Willlum/Model_M_Blu/refs/EaLr-zAWsAAkqea.jpg

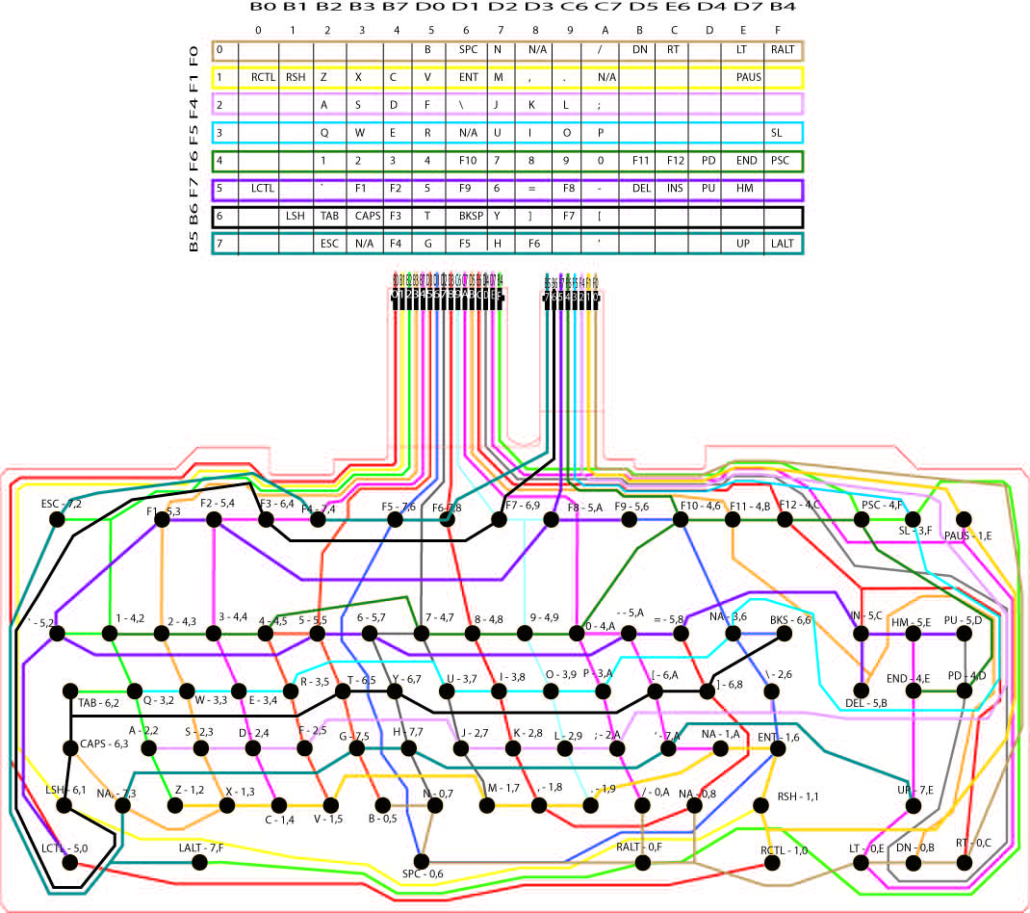
refs/EaLr-zAWsAAkqea.jpg
