Willlum/Model_M_Blu/pcb/BOM.xlsx

Index | Manufacturer Part Number | Manufacturer Name | Description | Attrition % | Datasheet | Note | Original Part numbers
1 | 6-520315-6 | TE Connectivity AMP Connectors | CONN FFC VERT 16POS 2.54MM PCB |  | https://www.te.com/commerce/DocumentDelivery/DDEController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 |  | 6-520315-6-ND
2 | 5-520315-8 | TE Connectivity AMP Connectors | CONN FFC VERT 8POS 2.54MM PCB |  | https://www.te.com/commerce/DocumentDelivery/DDEController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 |  | 5-520315-8-ND
3 | 5-520315-4 | TE Connectivity AMP Connectors | CONN FFC VERT 4POS 2.54MM PCB |  | https://www.te.com/commerce/DocumentDelivery/DDEController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 |  | A123169-ND
4 | PCF8575CDB | Texas Instruments | IC XPNDR 400KHZ I2C SMBUS 24SSOP |  | https://www.ti.com/general/docs/suppproductinfo.tsp?distId=10 |  | 296-33525-5-ND
5 | Huzzah32 |  |  |  | https://www.adafruit.com/product/3405
6 | Lithium Polymer Battery 3.7V |  |  |  | https://www.amazon.com/dp/B095VVR4LB?psc=1&ref=ppx_yo2ov_dt_b_product_details
7 | 1k 0802 RES |  | 1k Ohm
8 | 3k3 0802 RES |  | 3k3 Ohm
