Willlum/Model_M_Blu/pcb/blu_model_m/blu_model_m.kicad_pcb

## KiCad design pcb/blu_model_m/blu_model_m.kicad_pcb (2023-02-08)

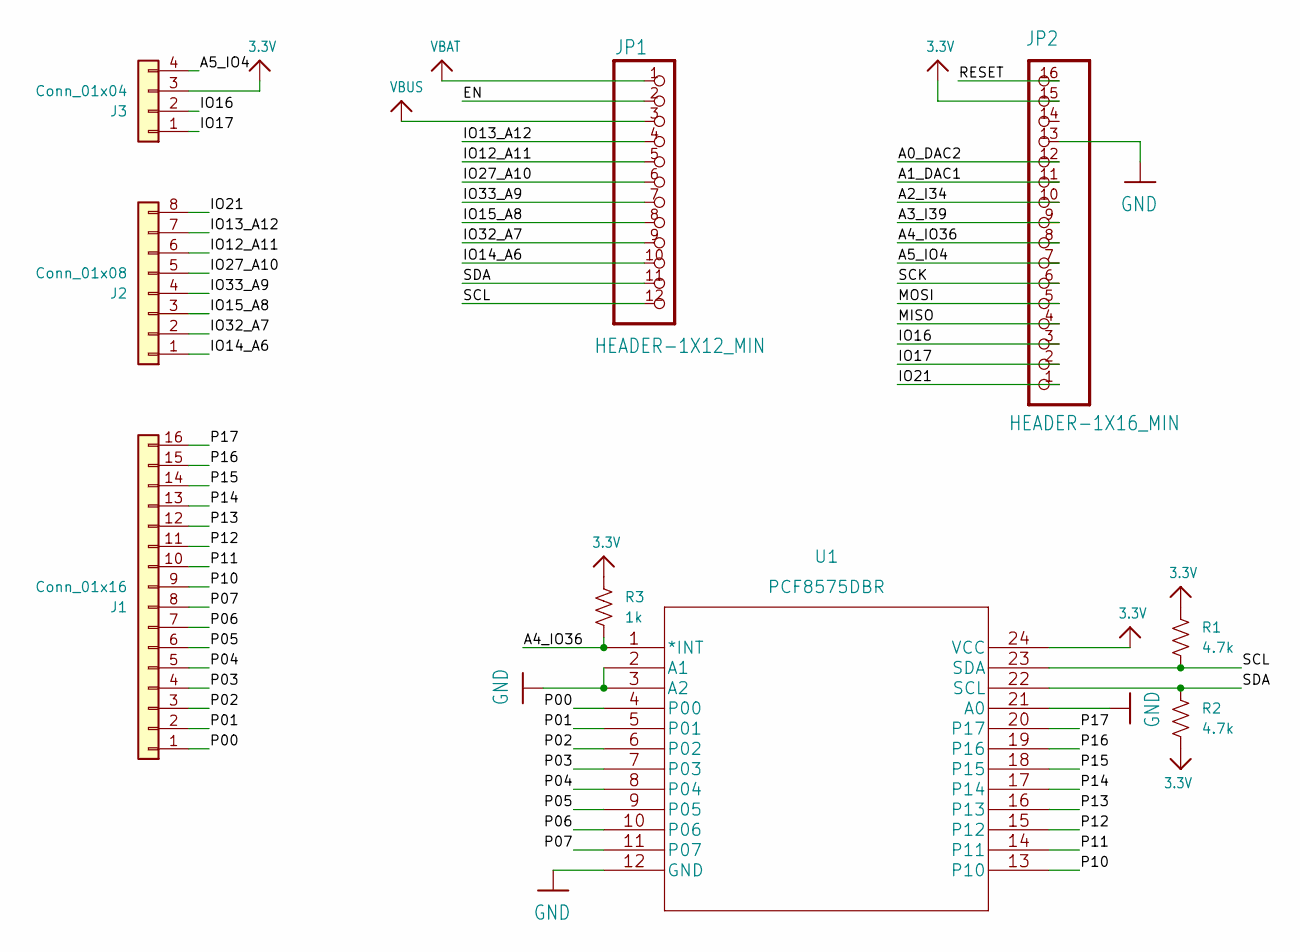
[picture p2: schematic blu_model_m.kicad_sch]

Parts:
J1: Conn_01x16; PinSocket_1x16_P2.54mm_Vertical
J2: Conn_01x08; PinSocket_1x08_P2.54mm_Vertical
J3: Conn_01x04; PinSocket_1x04_P2.54mm_Vertical
JP1: HEADER-1X12_MIN; PinSocket_1x12_P2.54mm_Vertical
JP2: HEADER-1X16_MIN; PinSocket_1x16_P2.54mm_Vertical
R1, R2: 4.7k; R_0805_2012Metric_Pad1.20x1.40mm_HandSolder
R3: 1k; R_0805_2012Metric_Pad1.20x1.40mm_HandSolder
U1: PCF8575DBR; SSOP-24_5.3x8.2mm_P0.65mm

Connections:
3.3V: J3.3, JP2.15, R1.1, R2.2, R3.1, U1.24 (VCC)
/A0_DAC2: JP2.12
/A1_DAC1: JP2.11
/A2_I34: JP2.10
/A3_I39: JP2.9
/A4_IO36: JP2.8, R3.2, U1.1 (*INT)
/A5_IO4: J3.4, JP2.7
/EN: JP1.2
/IO12_A11: J2.6, JP1.5
/IO13_A12: J2.7, JP1.4
/IO14_A6: J2.1, JP1.10
/IO15_A8: J2.3, JP1.8
/IO16: J3.2, JP2.3
/IO17: J3.1, JP2.2
/IO21: J2.8, JP2.1
/IO27_A10: J2.5, JP1.6
/IO32_A7: J2.2, JP1.9
/IO33_A9: J2.4, JP1.7
/MISO: JP2.4
/MOSI: JP2.5
/P00: J1.1, U1.4 (P00)
/P01: J1.2, U1.5 (P01)
/P02: J1.3, U1.6 (P02)
/P03: J1.4, U1.7 (P03)
/P04: J1.5, U1.8 (P04)
/P05: J1.6, U1.9 (P05)
/P06: J1.7, U1.10 (P06)
/P07: J1.8, U1.11 (P07)
/P10: J1.9, U1.13 (P10)
/P11: J1.10, U1.14 (P11)
/P12: J1.11, U1.15 (P12)
/P13: J1.12, U1.16 (P13)
/P14: J1.13, U1.17 (P14)
/P15: J1.14, U1.18 (P15)
/P16: J1.15, U1.19 (P16)
/P17: J1.16, U1.20 (P17)
/RESET: JP2.16
/SCK: JP2.6
/SCL: JP1.12, R1.2, U1.23 (SDA)
/SDA: JP1.11, R2.1, U1.22 (SCL)
GND: JP2.13, U1.2 (A1), U1.3 (A2), U1.12 (GND), U1.21 (A0)
VBAT: JP1.1
VBUS: JP1.3

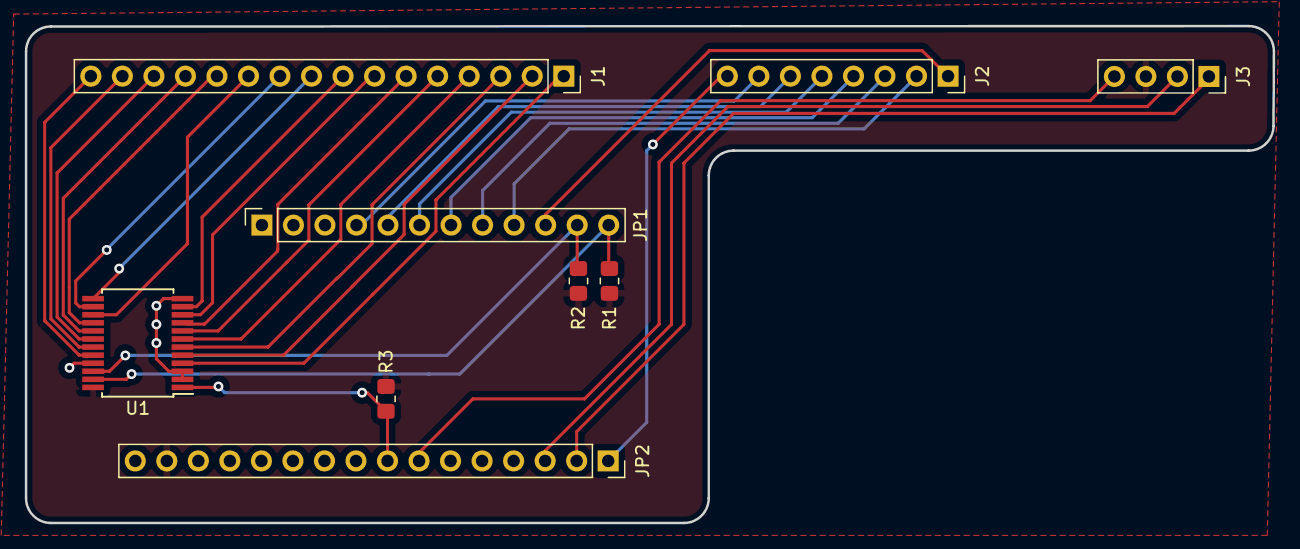
[picture p3: board blu_model_m.kicad_pcb from above]

Board: 2 copper layers, 100.5 x 40.0 mm, 9 parts (0 on the bottom side), 32 nets.
