Willlum/Model_M_Blu/src/main.cpp

#include <Arduino.h>
#include <BleKeyboard.h>
#include "keymap.h"
#include "PCF8575.h"

#define DEBUG false
#define NUM_LOCK 4 
#define CAPS_LOCK 16
#define SCROLL_LOCK 17 


PCF8575 PCF(0x20);
BleKeyboard bleKeyboard;
volatile int keyLayer = 0;
volatile int capState = 1;
volatile int numState = 0;
char buffer[64];

void setup() {
 
  Serial.begin(115200);

  pinMode(SCROLL_LOCK, OUTPUT);
  pinMode(CAPS_LOCK, OUTPUT);
  pinMode(NUM_LOCK, OUTPUT);
    
  PCF.begin();

  if (!PCF.isConnected())
  {
    while(1){
      digitalWrite(NUM_LOCK,HIGH);
      delay(250);
      digitalWrite(NUM_LOCK,LOW);
      delay(250);
    }
  }
  
  digitalWrite(SCROLL_LOCK,LOW);
  digitalWrite(CAPS_LOCK,LOW);
  digitalWrite(NUM_LOCK,LOW);
  delay(500);
  digitalWrite(SCROLL_LOCK,HIGH);
  digitalWrite(CAPS_LOCK,HIGH);
  digitalWrite(NUM_LOCK,HIGH);
  delay(250);

  //Set all inputs to low on gpio expander
  PCF.write16(0x00);
  for (int i = 0; i < MATRIX_ROWS; i++)
  {
    pinMode(rows[i], INPUT_PULLDOWN);
  }
  
  bleKeyboard.begin();

  while(!bleKeyboard.isConnected()) {
    digitalWrite(SCROLL_LOCK,LOW);
    delay(250);
    digitalWrite(CAPS_LOCK,LOW);
    delay(250);
    digitalWrite(NUM_LOCK,LOW);
    delay(250);
    digitalWrite(SCROLL_LOCK,HIGH);
    digitalWrite(CAPS_LOCK,HIGH);
    digitalWrite(NUM_LOCK,HIGH);
    delay(250);
  }
  
  digitalWrite(NUM_LOCK, numState);
}

void loop(){
  for (int colCnt = 0;colCnt < MATRIX_COLS; colCnt++){
    PCF.write(colCnt, HIGH);  
    for (int rowCnt = 0;rowCnt < MATRIX_ROWS; rowCnt++){
        //wiring of controller board was reveresed for simplicity. So indexing is reversed
        int col = (MATRIX_COLS - 1) - colCnt; 
        //Key pressed for the first time
        if(digitalRead(rows[rowCnt]) && pressedMap[keyLayer][rowCnt][col] == false ){
          switch(keymap[keyLayer][rowCnt][col]){
            case KEY_CAPS_LOCK:
              capState = !digitalRead(CAPS_LOCK);
              digitalWrite(CAPS_LOCK, capState);
              pressedMap[keyLayer][rowCnt][col] = true;
              keyLayer = !capState; //inverted becasue of LED logic
              break;
            case KEY_LEFT_SHIFT:
              bleKeyboard.press(keymap[keyLayer][rowCnt][col]);
              pressedMap[keyLayer][rowCnt][col] = true;
              keyLayer = capState;
              break;
            case KEY_RIGHT_SHIFT:
              bleKeyboard.press(keymap[keyLayer][rowCnt][col]);
              pressedMap[keyLayer][rowCnt][col] = true;
              keyLayer = capState;
              break;
            case KEY_NUM_LOCK:
              numState = !digitalRead(NUM_LOCK);
              digitalWrite(NUM_LOCK, numState);
              pressedMap[keyLayer][rowCnt][col] = true;
              break;
            case KEY_PAGE_UP:
              if(keyLayer == 1){
                bleKeyboard.press(KEY_MEDIA_VOLUME_UP);
                pressedMap[keyLayer][rowCnt][col] = true;
                break;
              }
            case KEY_PAGE_DOWN:
              if(keyLayer == 1){
                bleKeyboard.press(KEY_MEDIA_VOLUME_DOWN);
                pressedMap[keyLayer][rowCnt][col] = true;
                break;
              }
            default:
              bleKeyboard.press(keymap[keyLayer][rowCnt][col]);
              pressedMap[keyLayer][rowCnt][col] = true;
              #if DEBUG
              snprintf(buffer, sizeof buffer, "[%d,%d,%d] %c", keyLayer, rowCnt, col, keymap[keyLayer][rowCnt][col]);
              Serial.println(buffer);
              #endif
          }
        }
        //Key released
        else if(!digitalRead(rows[rowCnt]) && pressedMap[keyLayer][rowCnt][col] == true){
          switch(keymap[keyLayer][rowCnt][col]){
            case KEY_LEFT_SHIFT:
              if(capState) keyLayer = 0;
              else keyLayer = !capState; //inverted becasue of LED logic
              bleKeyboard.release(keymap[keyLayer][rowCnt][col]);
              pressedMap[keyLayer][rowCnt][col] = false;
              break;
            case KEY_RIGHT_SHIFT:
              if(capState) keyLayer = 0;
              else keyLayer = !capState;
              bleKeyboard.release(keymap[keyLayer][rowCnt][col]);
              pressedMap[keyLayer][rowCnt][col] = false;
              break;
            default:
              bleKeyboard.release(keymap[keyLayer][rowCnt][col]);
              pressedMap[keyLayer][rowCnt][col] = false;
          } 
        }
    }
    PCF.write(colCnt, LOW);  
  }
  delay(1);          
}
