Willlum/Model_M_Blu/include/keymap.h

#include "BleKeyboard.h"
#include <stdint.h>

#define MATRIX_ROWS 8
#define MATRIX_COLS 16
#define MATRIX_LAYERS 2

#define r0  14
#define r1  32
#define r2  15
#define r3  33
#define r4  27
#define r5  12
#define r6  13
#define r7  21

const uint8_t KEY_NUM_LOCK = 0xA1;

uint8_t rows[MATRIX_ROWS] = {r0, r1 , r2, r3, r4, r5, r6, r7};

uint8_t keymap[MATRIX_LAYERS][MATRIX_ROWS][MATRIX_COLS] = 
{ {{' ',' ',' ',' ',' ','b',' ','n',' ',' ',KEY_NUM_SLASH,KEY_DOWN_ARROW, KEY_RIGHT_ARROW,KEY_NUM_MINUS,KEY_LEFT_ARROW,KEY_RIGHT_ALT},
    {KEY_RIGHT_CTRL,KEY_RIGHT_SHIFT,'z','x','c','v',KEY_RETURN,'m',',','.',' ',KEY_NUM_LOCK, KEY_NUM_SLASH,KEY_NUM_ASTERISK,' ',' '},
    {' ',' ','a','s','d','f','\\','j','k','l',';',KEY_NUM_1,KEY_NUM_2,KEY_NUM_3,KEY_NUM_ENTER,' '},
    {' ',' ','q','w','e','r',' ','u','i','o','p',KEY_NUM_7,KEY_NUM_8,KEY_NUM_9,KEY_NUM_PLUS,' '},
    {' ',' ','1','2','3','4',KEY_F10,'7','8','9','0',KEY_F11,KEY_F12,KEY_PAGE_DOWN,KEY_END,KEY_PRTSC},
    {KEY_LEFT_CTRL,' ','`',KEY_F1,KEY_F2,'5',KEY_F9,'6','=',KEY_F8,'-',KEY_DELETE,KEY_INSERT,KEY_PAGE_UP,KEY_HOME,' '},
    {' ',KEY_LEFT_SHIFT, KEY_TAB, KEY_CAPS_LOCK,KEY_F3,'t',KEY_BACKSPACE,'y',']',KEY_F7,'[',KEY_NUM_4,KEY_NUM_5,KEY_NUM_6,' ',' '},
    {' ',' ',KEY_ESC,' ',KEY_F4,'g',KEY_F5,'h',KEY_F6,' ','\'',' ',KEY_NUM_0,KEY_NUM_PERIOD,KEY_UP_ARROW,KEY_LEFT_ALT}},

  {{' ',' ',' ',' ',' ','B',' ','N',' ',' ','?',KEY_DOWN_ARROW, KEY_RIGHT_ARROW,KEY_NUM_MINUS,KEY_LEFT_ARROW,KEY_RIGHT_ALT},
    {KEY_RIGHT_CTRL,KEY_RIGHT_SHIFT,'Z','X','C','V',KEY_RETURN,'M','<','>',' ',KEY_NUM_LOCK, KEY_NUM_SLASH,KEY_NUM_ASTERISK,' ',' '},
    {' ',' ','A','S','D','F','|','J','K','L',':',KEY_NUM_1,KEY_NUM_2,KEY_NUM_3,KEY_NUM_ENTER,' '},
    {' ',' ','Q','W','E','R',' ','U','I',KEY_NUM_0,'P',KEY_NUM_7,KEY_NUM_8,KEY_NUM_9, KEY_NUM_PLUS,' '},
    {' ',' ','!','@','#','$',KEY_F10,'&','*','(',')',KEY_F11,KEY_F12,KEY_PAGE_DOWN,KEY_END,KEY_PRTSC},
    {KEY_LEFT_CTRL,' ','~',KEY_F1,KEY_F2,'%',KEY_F9,'&','+',KEY_F8,'_',KEY_DELETE,KEY_INSERT,KEY_PAGE_UP,KEY_HOME,' '},
    {' ',KEY_LEFT_SHIFT, KEY_TAB, KEY_CAPS_LOCK,KEY_F3,'T',KEY_BACKSPACE,'Y','}',KEY_F7,'{',KEY_NUM_4,KEY_NUM_5,KEY_NUM_6,' ',' '},
    {' ',' ',KEY_ESC,' ',KEY_F4,'G',KEY_F5,'H',KEY_F6,' ','\"',KEY_NUM_0,KEY_NUM_0,KEY_NUM_PERIOD,KEY_UP_ARROW,KEY_LEFT_ALT}}
};

bool pressedMap[MATRIX_LAYERS][MATRIX_ROWS][MATRIX_COLS] = {false};
