Willlum/Model_M_Blu/(commit log)

2023-02-06 init commit
    [blu_model_m-B_Cu.gbr, blu_model_m-B_Mask.gbr, blu_model_m-B_Paste.gbr, blu_model_m-B_Silkscreen.gbr, blu_model_m-Edge_Cuts.gbr, blu_model_m-F_Cu.gbr, blu_model_m-F_Mask.gbr, blu_model_m-F_Paste.gbr]
2023-02-08 Updated pcb to v1.1. Format changes in code
    [blu_model_m-B_Cu.gbr, blu_model_m-B_Mask.gbr, blu_model_m-B_Paste.gbr, blu_model_m-B_Silkscreen.gbr, blu_model_m-Edge_Cuts.gbr, blu_model_m-F_Cu.gbr, blu_model_m-F_Mask.gbr, blu_model_m-F_Paste.gbr]
2023-02-19 moved and renamed bom
    [BOM.xlsx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]
